ekt0810/buom-c3-eco/outputs/buom_c3_eco/THIRD_PARTY.md

# Nguồn và giấy phép

- Firmware ECO, mô hình MATLAB, tài liệu, schematic và bố trí carrier trong gói được soạn mới cho prototype này.
- Dự án cơ khí tham khảo: Max Imagination / ESP-FLUTTER, https://github.com/maximagination1/ESP-FLUTTER . Firmware gốc mang PolyForm Noncommercial; không sao chép vào mã ECO. Gói không phân phối STL có phí, blueprint hoặc firmware gốc. Mua/tải chúng từ tác giả theo điều khoản riêng.
- Footprint chuẩn và footprint XIAO biên 14 pad sửa từ KiCad Libraries: https://www.kicad.org/libraries/license/ . Thư viện KiCad dùng CC-BY-SA 4.0 kèm ngoại lệ cho thiết kế mạch; giữ thông báo này khi phân phối thư viện chỉnh sửa. Các footprint chuẩn được nhúng trong board KiCad.
- Three.js v0.180.0, MIT: https://github.com/mrdoob/three.js . Các tệp vendor được lưu cục bộ; giấy phép trong viewer/vendor/LICENSE.txt.
- Ảnh concept được tạo bằng imagegen, rồi chỉnh thành bản tiết kiệm. Nó không mô tả một sản phẩm đã chế tạo hoặc kiểm định.
- Các nhãn hiệu/mã linh kiện thuộc chủ sở hữu tương ứng; không thể suy ra chính hãng hoặc tồn kho của người bán từ tài liệu này.
