ekt0810/buom-c3-eco/outputs/buom_c3_eco/hardware/schematic.pdf

1 | 2 | 3 | 4 | 5 | 6 | 7 | 8 | 9 | 10 | 11
1 | 2 | 3 | 4 | 5 | 6 | 7 | 8 | 9 | 10 | 11

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
FGH Date: 2026-11-12

Size: A2 | Rev: A - prototype
KiCad E.D.A. 10.0.8 | Id: 1/1

## Title: Buom C3 carrier

File: buom_c3.kicad_sch

Sheet: /

1

1 | 2

2 R4

10k 1

1 | 2

2 R1

100k 1%

1

1 | 2

2 C1

100n 16V

1

1 | 2

2 R2

33k 1%

K

1 | A

2 D1

SS14

1

1 | 2
2 | 3

3 4

4 J3

IMU 4438

1

1 | 2
2 | 3

3 J5

LEFT SERVO

1

1 | 2

2 C3

100n 16V

1OE 1 | 1A 2 | 2Y 3 | GND 4 | 2A | 5 1Y | 6 2OE | 7 VCC | 8 U2

74AHCT2G125DP

1

1 | 2
2 | 3
3 J4 RP1 TX OUT D0/G2_NC 1 | D1/G3 2 | D2/G4_ADC 3 | D3/G5 4 | D4/G6_SDA 5 | D5/G7_SCL 6 | D6/G21 7 | D7/G20_RX | 8 D8/G8_NC | 9 D9/G9_NC | 10 D10/G10 | 11 3V3_OUT | 12 GND | 13 5V_IN | 14 U1

XIAO ESP32-C3

1

1 | 2
2 | 3

3 J6 RIGHT SERVO

1

1 | 2

2 C2

10u 16V | G
1 | S
2 | D

3 Q2

2N7002

1

1 | 2

2 C5

220u 16V low ESR

1

1 | 2

2 R3

100k 1

1 | 2

2 C4

10u 16V

1

1 | 2

2 R7

100R

1

1 | 2

2 R8

100k

S

1 | S
2 | S
3 | G
4 | D

5 D

6 D

7 D

8 Q1

AO4407A

1

1 | 2

2 J7

LED WING BUS

1

1 | 2

2 R12

100k pwr 1 PWR_FLAG

1

1 | 2

2 J1

2S BAT 6.6-8.4V

G

1 | S
2 | D

3 Q3

AO3400A

1

1 | 2

2 R5

100R

1

1 | 2
2 | 3

# 3 J2 BUCK external 1

1 | 2

2 R6

100k pwr 1 PWR_FLAG pwr 1 PWR_FLAG | pwr 1 PWR_FLAG

1

1 | 2

2 R9

220R

1

1 | 2

2 R10

220R

1

1 | 2

2 R11

100k PGATE +5V

VSERVO

VBAT

VSERVO

VBAT

XIAO_5V | GND +5V
PWM_L_5V | GND
GND | VSERVO +3V3 | GND
SDA | PWM_R_5V SCL VBAT_ADC | GND

GND

GND

XIAO_5V +5V | +5V CRSF_RX | GND
GND | PWM_R_3V3 PWM_L_3V3 | PWM_L_BUF

VBAT_ADC

VSERVO | GND

SERVO_EN

VBAT VBAT | VSERVO

VSERVO

VSERVO

VBAT | PGATE

PWM_R_BUF +3V3

LED_EN | LED_GATE

+5V GND

# VBAT PGATE

GND

GND

VBAT GND

+5V | LED_RETURN

XIAO_5V

XIAO_5V

VBAT_ADC

LED_RETURN

GND

PWM_R_3V3

SDA

EN_GATE

VBAT_ADC

SCL

EN_GATE | GND

LED_EN

GND | +5V

NGATE_D

VBAT

CRSF_RX

GND

GND

LED_GATE SERVO_EN | +5V | GND
LED_GATE | GND | PWM_L_BUF | PWM_L_5V

EN_GATE

PWM_R_BUF | PWM_R_5V

PWM_L_3V3

PWM_L_3V3 | GND | NGATE_D
PWM_R_3V3 | GND Q1 source pins 1/2/3 -> VBAT; drains 5/6/7/8 -> VSERVO. Gate pulled to source by R3: servo power OFF at reset. PWM is forced LOW before switching servo rail OFF. Use keyed battery cable; no reverse-polarity protection.

## BUOM C3 / REV A / 2S HV SERVO CARRIER

Do not fit a 1S-only servo or SG90/MG90S. Bench checks: polarity, 5V regulation, 3V3, ADC scale, servo pulse range, idle-off rail, current peaks, RF failsafe. U1 BAT pads NC. NEVER connect 2S to XIAO BAT or 5V. J2: external regulated 5V >= 1A; common GND. D1 prevents USB feeding the external 5V bus. J4: receiver TX -> MCU RX. Receiver RX unconnected.

Prototype: electrical CAD verified; flight and thermal performance unmeasured.

J7: 40 parallel LED branches, EACH with its own 2k2 resistor. White LED: +5V -> 2k2 -> anode; cathode -> LED_RETURN.

IMU at CG: X forward, Y left, Z up; leads <= 50mm. Digital signal levels are 3.3V except buffered servo PWM.
