ekt0810/buom-c3-eco/outputs/buom_c3_eco/images/pcb_top.png

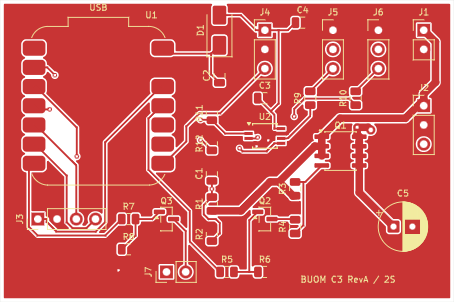
outputs/buom_c3_eco/images/pcb_top.png
