ekt0810/buom-c3-eco/outputs/buom_c3_eco/images/viewer_preview.png

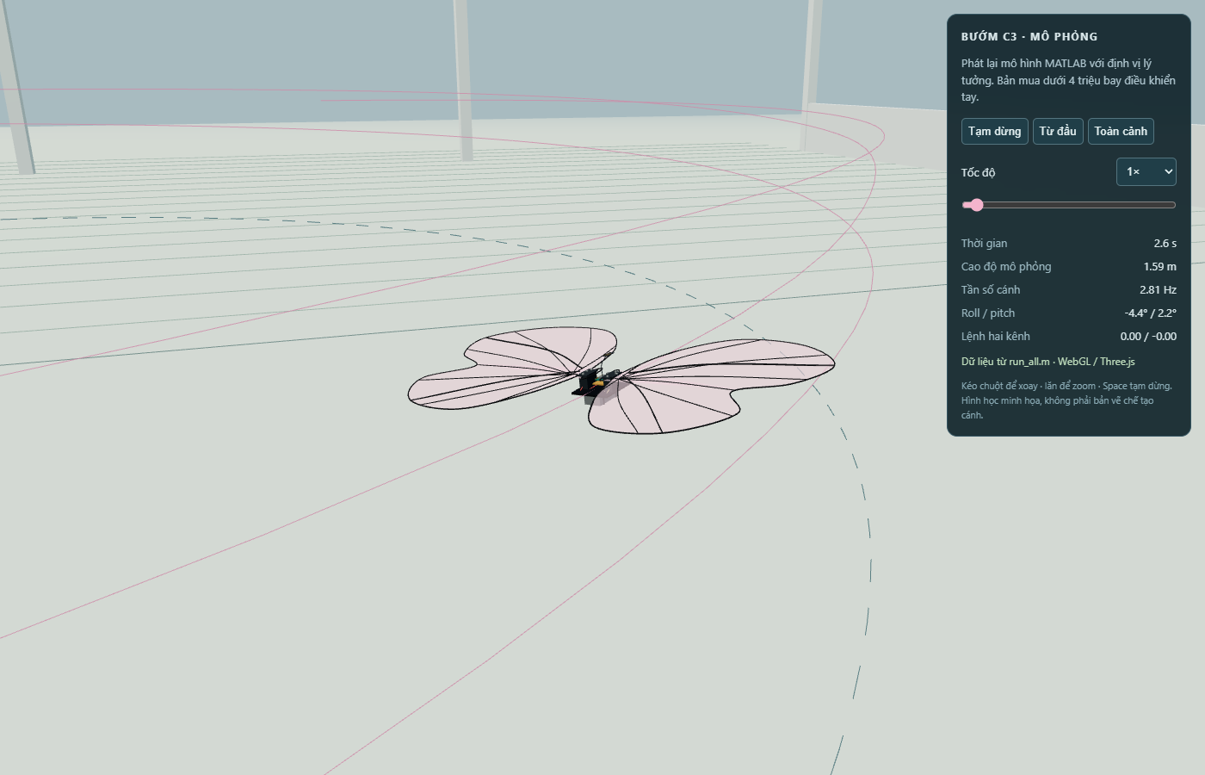
outputs/buom_c3_eco/images/viewer_preview.png
