ekt0810/buom-c3-eco/outputs/buom_c3_eco/BOM_Buom_C3.xlsx

Sheet: Mua linh kien
C3 ECO | BẢN TIẾT KIỆM / ESP-NOW
 | Điều khiển tay • không LED/IMU/ELRS |  |  |  |  |  |  | Giá dự toán, cần kiểm tra khi đặt hàng | Đã gồm 400k vận chuyển/dự phòng; chưa gồm dụng cụ đo/hàn.
 | Dự toán 12/11/2026; chưa có báo giá chốt |  | Trần ngân sách | 4000000 |  |  |  | Cột G: khối lượng vật tư mua | Khối lượng cất cánh tính riêng ở tab Khối lượng.
 |  |  | Tổng dự toán | 3865000
 |  |  | Dư địa còn lại | 135000
ID | Linh kiện / mã cụ thể | SL mua | Đơn giá VND | Thành tiền VND | g/đv tham khảo | Khối lượng mua | Nhóm | Nguồn / link hãng | Ghi chú đặt hàng
A01 | XIAO ESP32-C3 + anten đi kèm | 1 | 170000 | 170000 | 3.50 | 3.50 | Bướm | https://hshop.vn/mach-seeed-studio-xiao-esp32c3-risc-v-with-wi-fi-bluetooth5-0-battery-charge-supported | Giá tham khảo; các giá còn lại là dự toán cần hỏi người bán.
A02 | SDS1601 HV 180° / 2S, kèm horn | 2 | 650000 | 1300000 | 16.00 | 32.00 | Bướm | https://www.elektormagazine.com/labs/make-an-esp32-rc-bionic-butterfly-that-flies-esp-flutter | Mục trần: <=650k/con. Phải đúng bản HV chịu pin đầy 8.4V và >=750°/s không tải. Đặt theo link parts của tác giả, không thay SG90.
A03 | LiPo 2S 220mAh >=45C | 1 | 220000 | 220000 | 13.00 | 13.00 | Bướm | https://www.elektormagazine.com/labs/make-an-esp32-rc-bionic-butterfly-that-flies-esp-flutter | Chỉ mua 1 pin đợt đầu. Xác nhận dòng tải, kích thước, cân nặng và giắc.
A04 | Mini-360 MP2307 buck chỉnh 5.0V | 1 | 30000 | 30000 | 2.00 | 2.00 | Bướm | https://www.monolithicpower.com/en/mp2307.html | Dự toán module; đo 5.0V trước cắm XIAO. Thử 0.5A liên tục; không lấy 5V cấp servo HV.
A05 | Bộ mạch nguồn/PWM + bảng lỗ nhỏ | 1 | 90000 | 90000 | 2.00 | 2.00 | Bướm | Schematic và tab PCB trong gói | Gồm AHCT2G125 + adapter TSSOP, SS14, AO4407A, 2N7002, R/C, dây. Nếu khó hàn: dùng PCB carrier tùy chọn trong khoản dự phòng.
M01 | Carbon 1mm (1m/cây) | 4 | 45000 | 180000 | 10.00 | 40.00 | Cơ khí | https://www.elektormagazine.com/labs/make-an-esp32-rc-bionic-butterfly-that-flies-esp-flutter | Cắt theo bản cánh gốc; khối lượng đây là vật tư mua, không phải khối lượng lắp.
M02 | Carbon 1.5mm (1m) | 1 | 60000 | 60000 | 3.00 | 3.00 | Cơ khí | Nguồn cơ khí của ESP-FLUTTER | Không phóng tỷ lệ cánh tùy ý.
M03 | Màng PE 10-20um khoảng 0.5m² | 1 | 50000 | 50000 | 10.00 | 10.00 | Cơ khí | Quy cách tìm mua; chưa xác nhận nhà bán | Cân tổng hai bên cánh + gân + keo <=16g làm mục tiêu ban đầu.
M04 | Khung đúng servo: file gốc + in nhẹ | 1 | 250000 | 250000 | 5.00 | 5.00 | Cơ khí | https://cults3d.com/en/3d-model/game/esp-flutter-an-esp32-bionic-rc-butterfly-that-flies-3d-design-files-max_imagination | Dự toán tổng. File gốc có phí, không kèm trong gói. Giữ hình học cơ sở đã bay; không dùng hình AI làm bản cắt.
M05 | Vít, keo, horn, dây, XT30, băng dính | 1 | 100000 | 100000 | 4.00 | 4.00 | Bướm | Quy cách lắp trong hướng dẫn | Dây pin và servo 24AWG ngắn; tín hiệu 30AWG. Horn lấy theo servo.
T01 | ESP32 DevKit V1 / ESP32-WROOM-32 | 1 | 120000 | 120000 | 0.00 | 0.00 | Tay phát | https://docs.espressif.com/projects/arduino-esp32/en/latest/ | Board mặt đất; không dùng ESP32-C3 thay chân mà không sửa firmware.
T02 | Joystick XY 10k + biến trở ga 10k | 1 | 35000 | 35000 | 0.00 | 0.00 | Tay phát | ADC1 GPIO32/33/34, dùng nguồn 3.3V | Joystick điều khiển roll/pitch; núm ga không tự hồi. Hiệu chuẩn ADC trước arm.
T03 | Công tắc ARM, piezo, LED, hộp, dây | 1 | 50000 | 50000 | 0.00 | 0.00 | Tay phát | Sơ đồ tay phát trong hướng dẫn | Piezo thụ động qua 1k; LED qua 1k. ARM nối GPIO25 xuống GND.
T04 | Nguồn USB 5V/power bank nhỏ cho tay phát | 1 | 150000 | 150000 | 0.00 | 0.00 | Tay phát | Có thể dùng power bank sẵn có để tiết kiệm | Tránh power bank tự tắt ở tải thấp; thử 15 phút.
G01 | Sạc cân bằng 2S, chỉnh được dòng 0.2A | 1 | 450000 | 450000 | 0.00 | 0.00 | Mặt đất | Yêu cầu mua: 2S LiPo balance, dòng 0.2A | Không mua sạc 1S TP4056. Sạc theo thông số pin; 1C của 220mAh là 0.22A.
G02 | Túi sạc và dây cân bằng phù hợp pin | 1 | 60000 | 60000 | 0.00 | 0.00 | Mặt đất | Quy cách theo giắc pin | Dự toán. Không dùng cổng BAT của XIAO để sạc 2S.
G03 | Nguồn DC cho sạc, dự toán 12V 3A | 1 | 150000 | 150000 | 0.00 | 0.00 | Mặt đất | Theo điện áp/giắc IN của bộ sạc thực mua | Bổ sung để không thiếu nguồn sạc. Chỉ chọn 12V khi bộ sạc hỗ trợ; nguồn SELV có vỏ, không nguồn hở. Nếu sạc đã tích hợp AC thì bỏ mục này.
D01 | Dự phòng vận chuyển / linh kiện lỗi | 1 | 400000 | 400000 | 0.00 | 0.00 | Dự phòng | Ngân sách dự phòng, không phải báo giá | Có thể dùng một phần để làm carrier PCB hoặc thuê hàn.

Sheet: PCB
PCB | PCB TÙY CHỌN / KHÔNG BẮT BUỘC
 | Bản tiết kiệm dùng bảng lỗ theo cùng netlist |  | DNP: J3, J4, J7, Q3, R7, R8 | Không mua IMU, ELRS, LED. U1 đã nằm ở A01; vật tư mạch nằm ở A05.
Refdes | Giá trị / MPN | SL | Footprint | Net từng pad
U1 | XIAO ESP32-C3 | 1 | Buom:MCU_Seeed_C3_top14 | 1:NC; 2:PWM_L_3V3; 3:VBAT_ADC; 4:PWM_R_3V3; 5:SDA; 6:SCL; 7:LED_EN; 8:CRSF_RX; 9:NC; 10:NC; 11:SERVO_EN; 12:+3V3; 13:GND; 14:XIAO_5V
J1 | 2S BAT 6.6-8.4V | 1 | Connector_PinHeader_2.54mm:PinHeader_1x02_P2.54mm_Vertical | 1:VBAT; 2:GND
J2 | BUCK external | 1 | Connector_PinHeader_2.54mm:PinHeader_1x03_P2.54mm_Vertical | 1:VBAT; 2:GND; 3:+5V
J3 | IMU 4438 | 0 | Connector_PinHeader_2.54mm:PinHeader_1x04_P2.54mm_Vertical | 1:+3V3; 2:GND; 3:SDA; 4:SCL
J4 | RP1 TX OUT | 0 | Connector_PinHeader_2.54mm:PinHeader_1x03_P2.54mm_Vertical | 1:+5V; 2:GND; 3:CRSF_RX
J5 | LEFT SERVO | 1 | Connector_PinHeader_2.54mm:PinHeader_1x03_P2.54mm_Vertical | 1:GND; 2:VSERVO; 3:PWM_L_5V
J6 | RIGHT SERVO | 1 | Connector_PinHeader_2.54mm:PinHeader_1x03_P2.54mm_Vertical | 1:GND; 2:VSERVO; 3:PWM_R_5V
J7 | LED WING BUS | 0 | Connector_PinHeader_2.54mm:PinHeader_1x02_P2.54mm_Vertical | 1:+5V; 2:LED_RETURN
U2 | 74AHCT2G125DP | 1 | Package_SO:TSSOP-8_3x3mm_P0.65mm | 1:GND; 2:PWM_L_3V3; 3:PWM_R_BUF; 4:GND; 5:PWM_R_3V3; 6:PWM_L_BUF; 7:GND; 8:+5V
R1 | 100k 1% | 1 | Resistor_SMD:R_0805_2012Metric | 1:VBAT; 2:VBAT_ADC
R2 | 33k 1% | 1 | Resistor_SMD:R_0805_2012Metric | 1:VBAT_ADC; 2:GND
C1 | 100n 16V | 1 | Capacitor_SMD:C_0805_2012Metric | 1:VBAT_ADC; 2:GND
D1 | SS14 | 1 | Diode_SMD:D_SMA | 1:XIAO_5V; 2:+5V
C2 | 10u 16V | 1 | Capacitor_SMD:C_0805_2012Metric | 1:XIAO_5V; 2:GND
C3 | 100n 16V | 1 | Capacitor_SMD:C_0805_2012Metric | 1:+5V; 2:GND
C4 | 10u 16V | 1 | Capacitor_SMD:C_0805_2012Metric | 1:+5V; 2:GND
Q1 | AO4407A | 1 | Package_SO:SOIC-8_3.9x4.9mm_P1.27mm | 1:VBAT; 2:VBAT; 3:VBAT; 4:PGATE; 5:VSERVO; 6:VSERVO; 7:VSERVO; 8:VSERVO
R3 | 100k | 1 | Resistor_SMD:R_0805_2012Metric | 1:VBAT; 2:PGATE
R4 | 10k | 1 | Resistor_SMD:R_0805_2012Metric | 1:PGATE; 2:NGATE_D
Q2 | 2N7002 | 1 | Package_TO_SOT_SMD:SOT-23 | 1:EN_GATE; 2:GND; 3:NGATE_D
R5 | 100R | 1 | Resistor_SMD:R_0805_2012Metric | 1:SERVO_EN; 2:EN_GATE
R6 | 100k | 1 | Resistor_SMD:R_0805_2012Metric | 1:EN_GATE; 2:GND
Q3 | AO3400A | 0 | Package_TO_SOT_SMD:SOT-23 | 1:LED_GATE; 2:GND; 3:LED_RETURN
R7 | 100R | 0 | Resistor_SMD:R_0805_2012Metric | 1:LED_EN; 2:LED_GATE
R8 | 100k | 0 | Resistor_SMD:R_0805_2012Metric | 1:LED_GATE; 2:GND
R9 | 220R | 1 | Resistor_SMD:R_0805_2012Metric | 1:PWM_L_BUF; 2:PWM_L_5V
R10 | 220R | 1 | Resistor_SMD:R_0805_2012Metric | 1:PWM_R_BUF; 2:PWM_R_5V
R11 | 100k | 1 | Resistor_SMD:R_0805_2012Metric | 1:PWM_L_3V3; 2:GND
R12 | 100k | 1 | Resistor_SMD:R_0805_2012Metric | 1:PWM_R_3V3; 2:GND
C5 | 220u 16V low ESR | 1 | Capacitor_THT:CP_Radial_D6.3mm_P2.50mm | 1:VSERVO; 2:GND

Sheet: Khoi luong
KHỐI LƯỢNG | BẢN TIẾT KIỆM
Ước tính, chưa cân mẫu thật |  |  | Cân từng cụm; không bay nếu lực nâng thử không đủ.
Cụm lắp trên bướm | Ước tính g | Đo thực g | Ghi chú
2 servo HV | 32.00 |  | Chưa cân
Cánh + carbon | 16.00 |  | Chưa cân
Khung, horn, vít | 5.00 |  | Chưa cân
Pin 2S 220mAh | 13.00 |  | Chưa cân
XIAO + anten | 3.50 |  | Chưa cân
Mini360 buck | 2.00 |  | Chưa cân
Mạch bảng lỗ + linh kiện | 2.00 |  | Chưa cân
Dây, giắc, keo | 4.00 |  | Chưa cân
LED (không lắp) | 0.00 |  | Chưa cân
IMU (không lắp) | 0.00 |  | Chưa cân
ELRS (không lắp) | 0.00 |  | Chưa cân
Tải mang (không lắp) | 0.00 |  | Chưa cân
Tổng dự kiến (không LED / tải) | 77.50
Khối lượng dùng cho mô phỏng | 77.50
Lực nâng mục tiêu 1.3 x trọng lượng (N) | 0.99
