ekt0810/buom-c3-eco/outputs/buom_c3_eco/matlab/results/trajectory.csv

t | x | y | z | V | psi | phi | theta | wingL_deg | wingR_deg | uRoll | uPitch | f_Hz
0 | 8 | 0 | 1.5 | 2 | 1.5707963 | -0.050924333 | 0 | 0.45075037 | 0.45075037 | -0.072873649 | 0.031552526 | 2.861547
0.02 | 8.0039 | 0.037999835 | 1.5001987 | 2.0000004 | 1.5757975 | -0.050970053 | 1.3860812e-05 | 8.8602119 | 9.672899 | -0.06741536 | 0.033355489 | 2.8567105
0.04 | 8.0075997 | 0.075998706 | 1.5007549 | 2.000005 | 1.580813 | -0.051247258 | 9.4809378e-05 | 16.068524 | 17.185542 | -0.04952239 | 0.012605253 | 2.8525396
0.06 | 8.0110981 | 0.11399576 | 1.5016135 | 2.0000223 | 1.5858731 | -0.051891228 | 0.00027744636 | 21.595443 | 22.837907 | -0.041172022 | 0.014862305 | 2.8489782
0.08 | 8.0143925 | 0.1519903 | 1.5027251 | 2.0000633 | 1.5910164 | -0.05293968 | 0.00058361919 | 24.35475 | 25.851507 | -0.044066806 | 0.023556117 | 2.8459683
0.1 | 8.0174789 | 0.18998178 | 1.504046 | 2.00014 | 1.5962821 | -0.054376881 | 0.0010215176 | 24.252685 | 25.125825 | -0.02609978 | 0.020704188 | 2.8434525
0.12 | 8.0203516 | 0.2279698 | 1.5055371 | 2.0002644 | 1.601706 | -0.056150772 | 0.0015851801 | 20.800537 | 21.439509 | -0.022249909 | 0.012588803 | 2.8413756
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
