ekt0810/buom-c3-eco/outputs/buom_c3_eco/matlab/results/gust_comparison.png

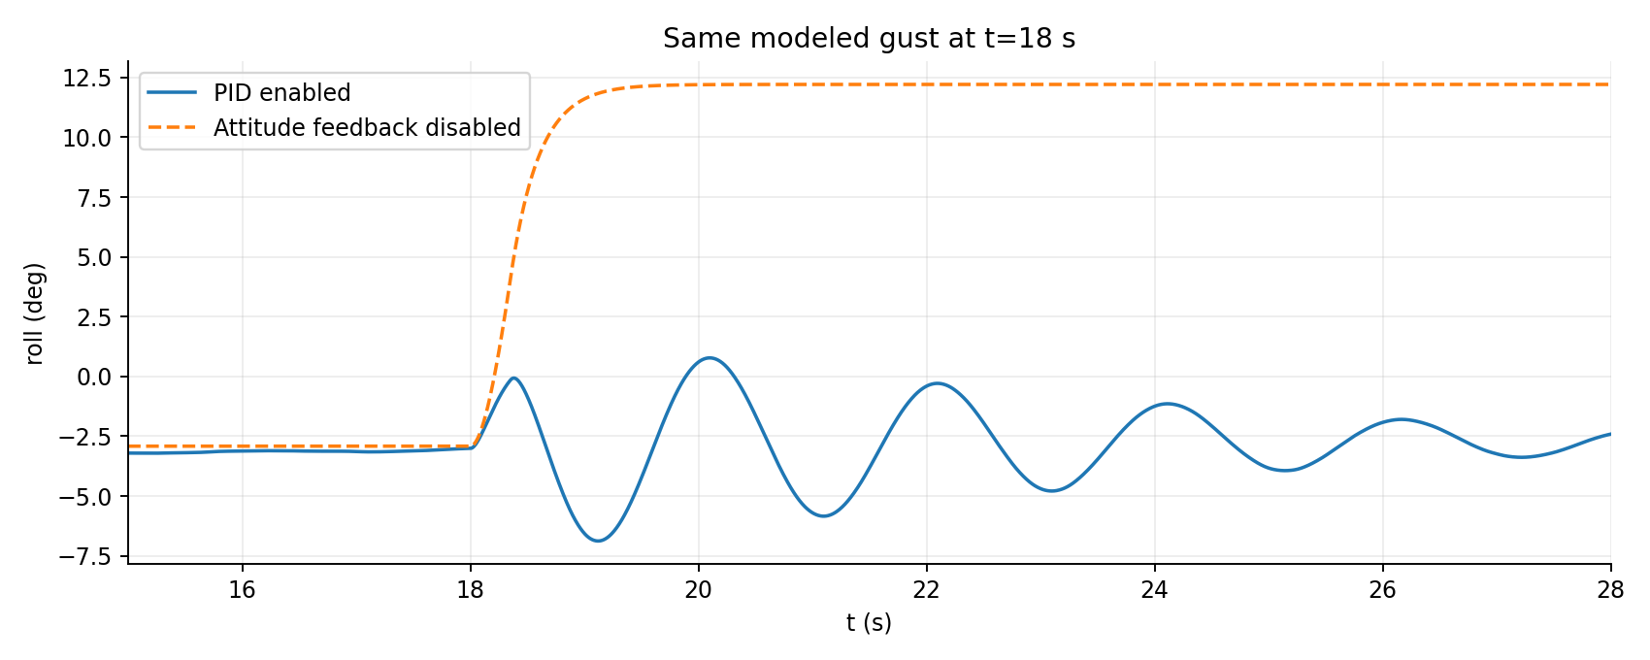
outputs/buom_c3_eco/matlab/results/gust_comparison.png
