ekt0810/buom-c3-eco/outputs/buom_c3_eco/hardware/buom_c3.kicad_pcb

## KiCad design outputs/buom_c3_eco/hardware/buom_c3.kicad_pcb (2026-11-12)

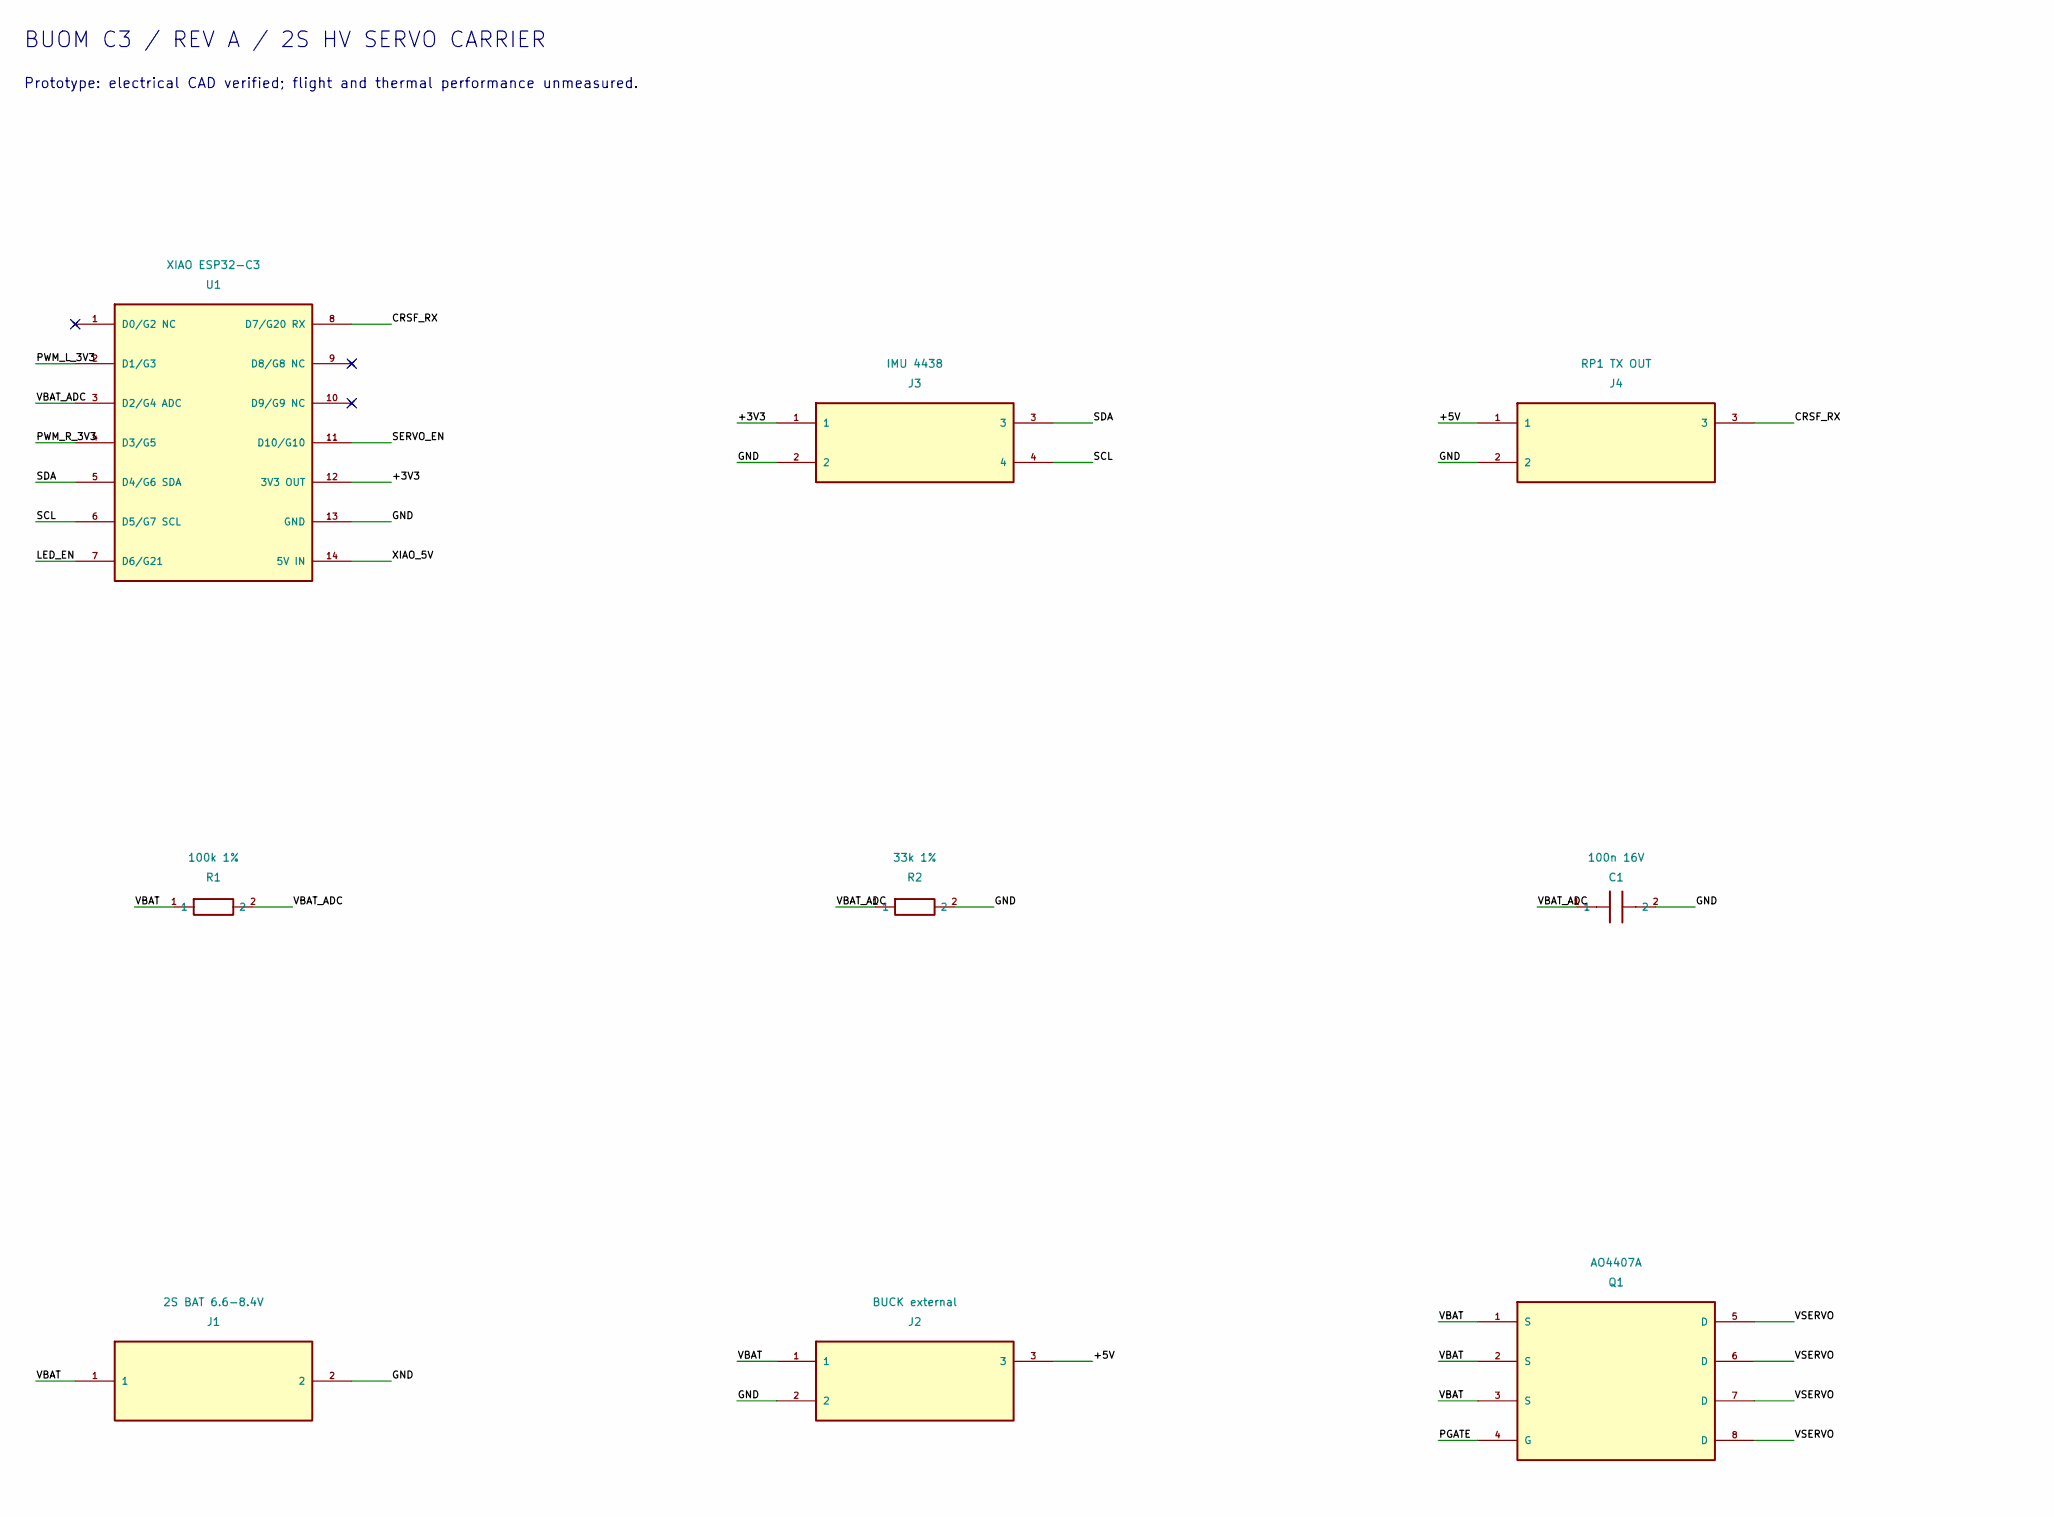
[picture p8: schematic buom_c3.kicad_sch, Buom C3 carrier, part in row 1, column 1]

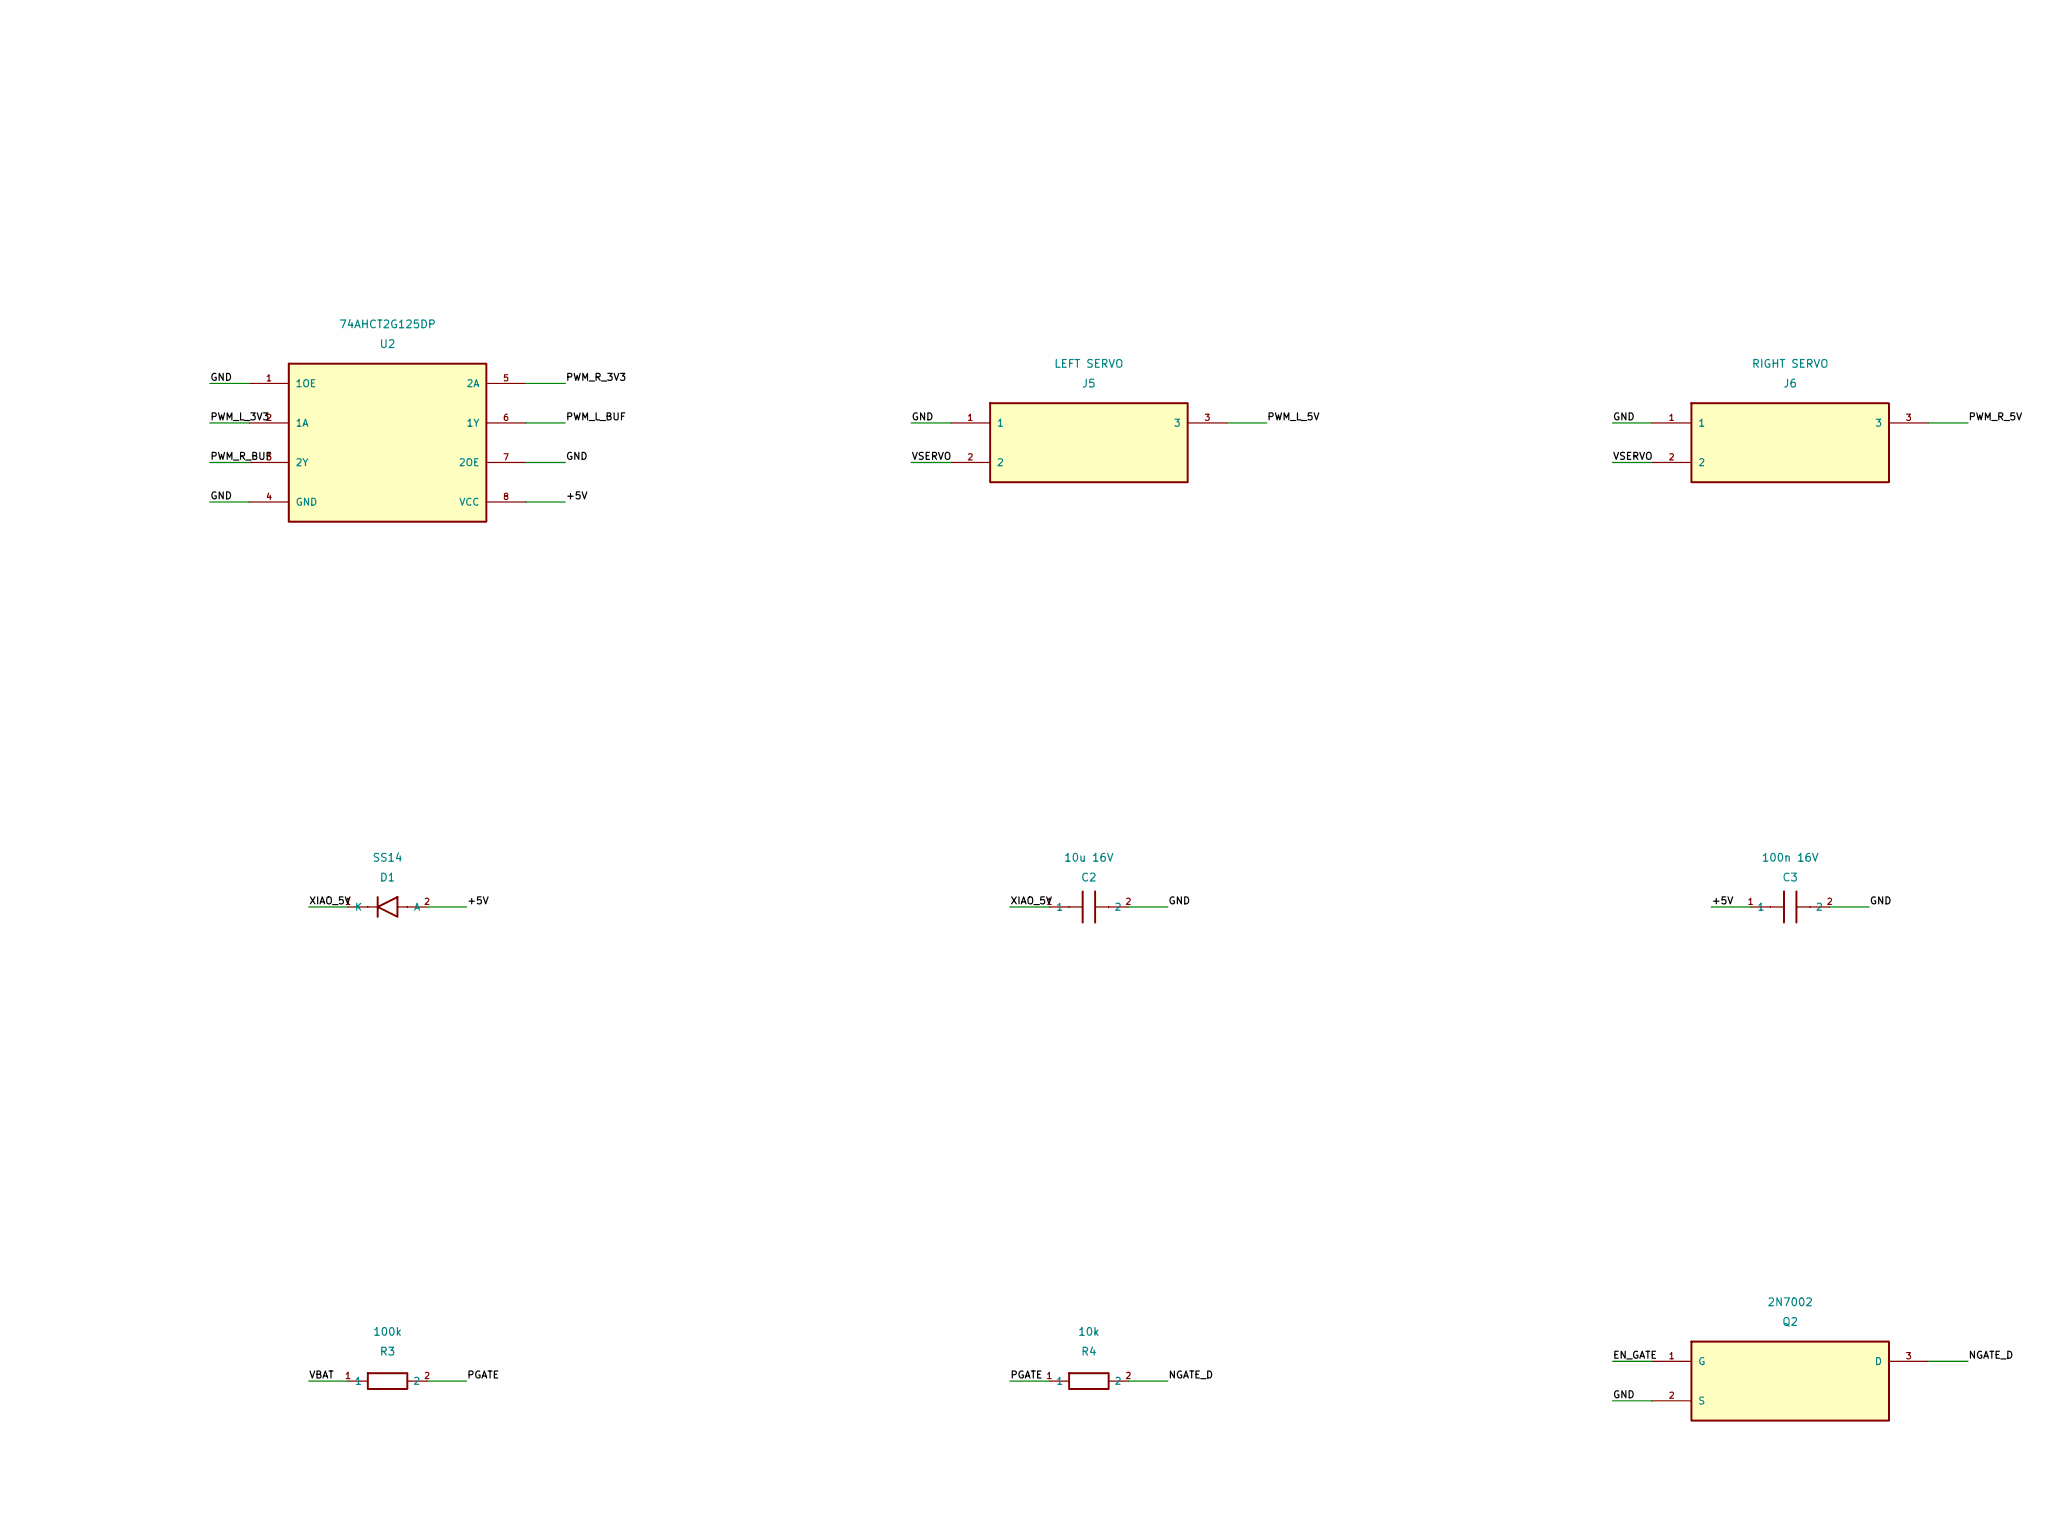
[picture p9: schematic buom_c3.kicad_sch, Buom C3 carrier, part in row 1, column 2]

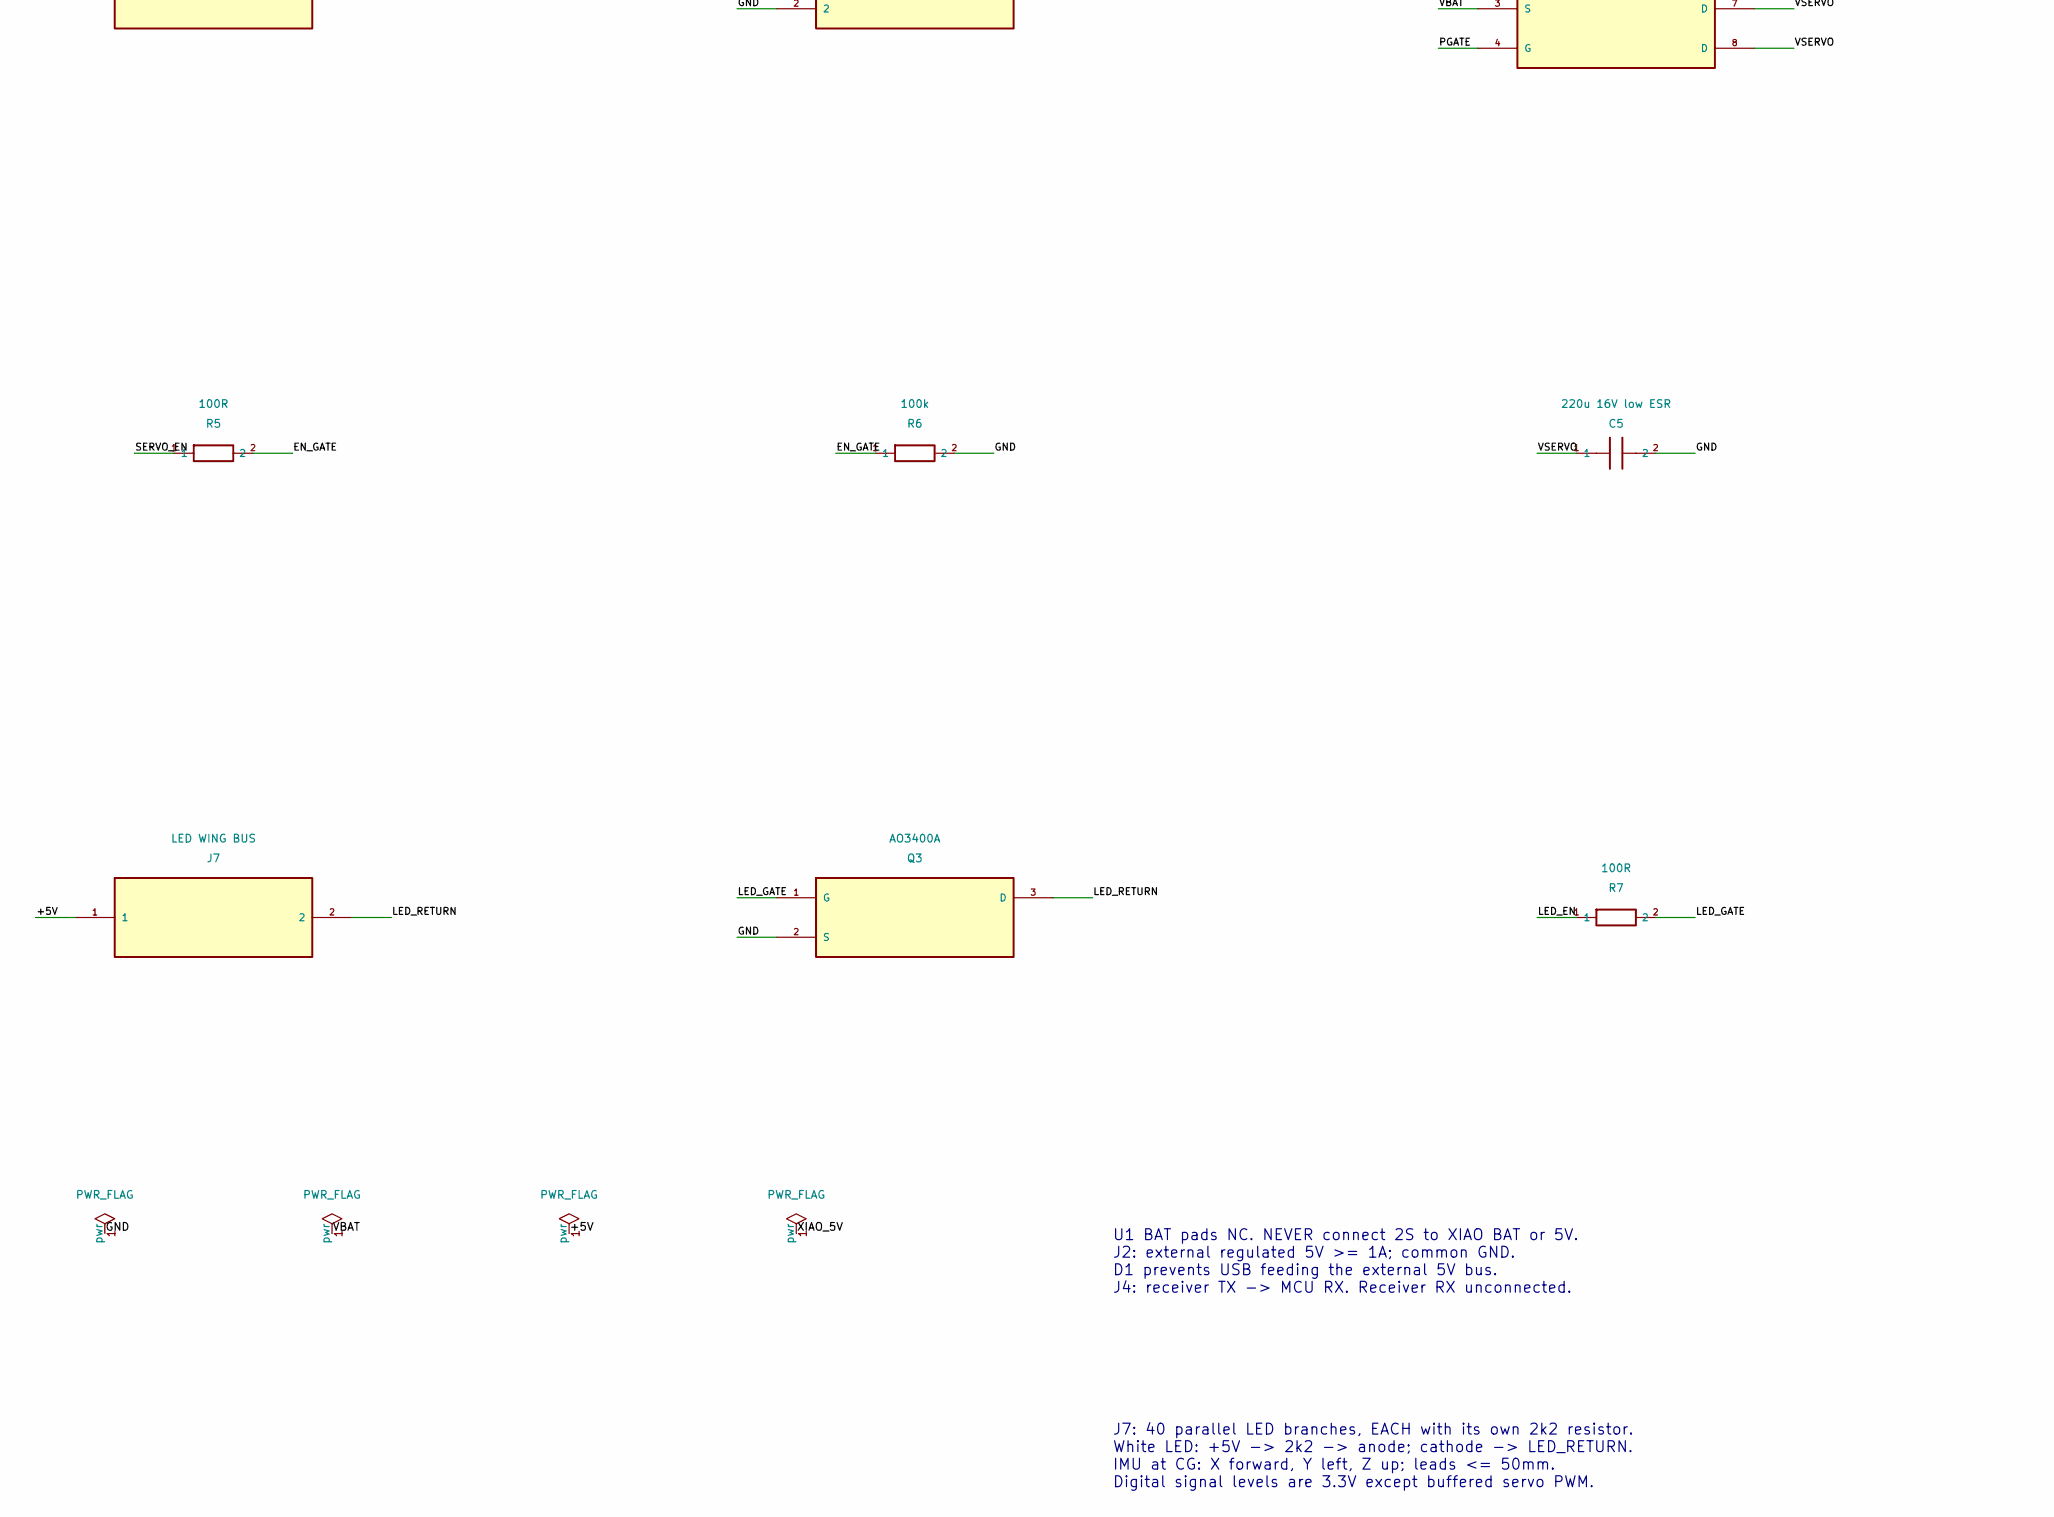
[picture p10: schematic buom_c3.kicad_sch, Buom C3 carrier, part in row 2, column 1]

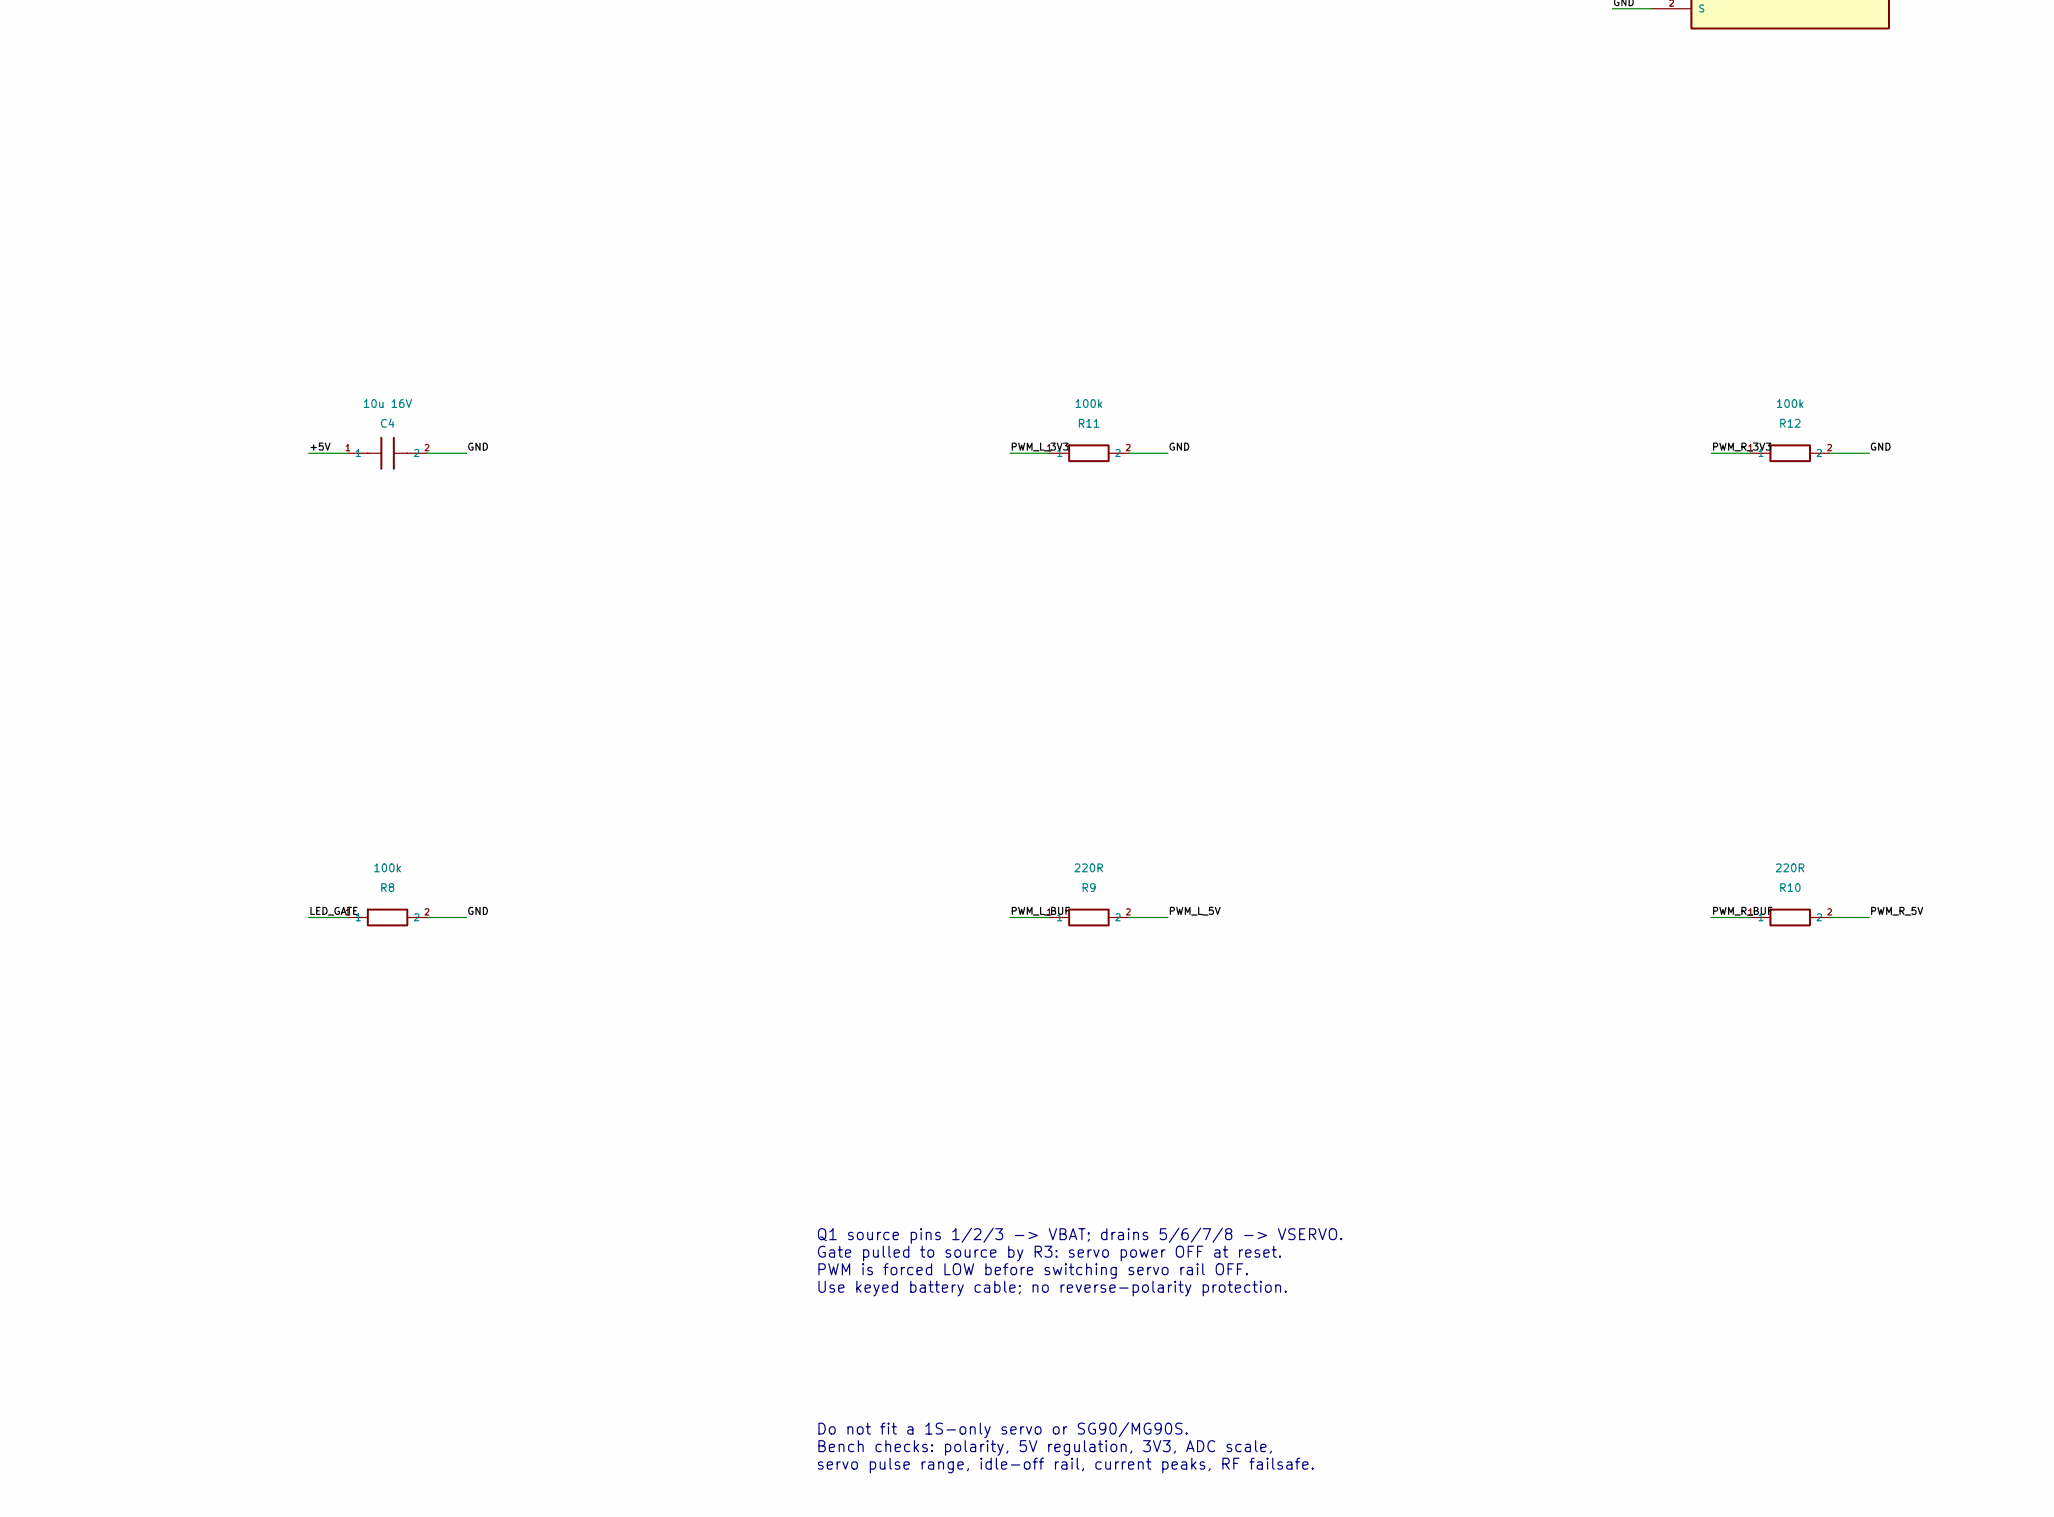
[picture p11: schematic buom_c3.kicad_sch, Buom C3 carrier, part in row 2, column 2]

Parts:
C1, C3: 100n 16V; C_0805_2012Metric
C2, C4: 10u 16V; C_0805_2012Metric
C5: 220u 16V low ESR; CP_Radial_D6.3mm_P2.50mm
D1: SS14; D_SMA
J1: 2S BAT 6.6-8.4V; PinHeader_1x02_P2.54mm_Vertical
J2: BUCK external; PinHeader_1x03_P2.54mm_Vertical
J3: IMU 4438; PinHeader_1x04_P2.54mm_Vertical
J4: RP1 TX OUT; PinHeader_1x03_P2.54mm_Vertical
J5: LEFT SERVO; PinHeader_1x03_P2.54mm_Vertical
J6: RIGHT SERVO; PinHeader_1x03_P2.54mm_Vertical
J7: LED WING BUS; PinHeader_1x02_P2.54mm_Vertical
Q1: AO4407A; SOIC-8_3.9x4.9mm_P1.27mm
Q2: 2N7002; SOT-23
Q3: AO3400A; SOT-23
R1: 100k 1%; R_0805_2012Metric
R2: 33k 1%; R_0805_2012Metric
R3, R6, R8, R11, R12: 100k; R_0805_2012Metric
R4: 10k; R_0805_2012Metric
R5, R7: 100R; R_0805_2012Metric
R9, R10: 220R; R_0805_2012Metric
U1: XIAO ESP32-C3; MCU_Seeed_C3_top14
U2: 74AHCT2G125DP; TSSOP-8_3x3mm_P0.65mm

Connections:
/+3V3: J3.1, U1.12 (3V3 OUT)
/+5V: C3.1, C4.1, D1.2 (A), J2.3, J4.1, J7.1, U2.8 (VCC)
/CRSF_RX: J4.3, U1.8 (D7/G20 RX)
/EN_GATE: Q2.1 (G), R5.2, R6.1
/GND: C1.2, C2.2, C3.2, C4.2, C5.2, J1.2, J2.2, J3.2, J4.2, J5.1, J6.1, Q2.2 (S), Q3.2 (S), R2.2, R6.2, R8.2, R11.2, R12.2, U1.13 (GND), U2.1 (1OE), U2.4 (GND), U2.7 (2OE)
/LED_EN: R7.1, U1.7 (D6/G21)
/LED_GATE: Q3.1 (G), R7.2, R8.1
/LED_RETURN: J7.2, Q3.3 (D)
/NGATE_D: Q2.3 (D), R4.2
/PGATE: Q1.4 (G), R3.2, R4.1
/PWM_L_3V3: R11.1, U1.2 (D1/G3), U2.2 (1A)
/PWM_L_5V: J5.3, R9.2
/PWM_L_BUF: R9.1, U2.6 (1Y)
/PWM_R_3V3: R12.1, U1.4 (D3/G5), U2.5 (2A)
/PWM_R_5V: J6.3, R10.2
/PWM_R_BUF: R10.1, U2.3 (2Y)
/SCL: J3.4, U1.6 (D5/G7 SCL)
/SDA: J3.3, U1.5 (D4/G6 SDA)
/SERVO_EN: R5.1, U1.11 (D10/G10)
/VBAT: J1.1, J2.1, Q1.1 (S), Q1.2 (S), Q1.3 (S), R1.1, R3.1
/VBAT_ADC: C1.1, R1.2, R2.1, U1.3 (D2/G4 ADC)
/VSERVO: C5.1, J5.2, J6.2, Q1.5 (D), Q1.6 (D), Q1.7 (D), Q1.8 (D)
/XIAO_5V: C2.1, D1.1 (K), U1.14 (5V IN)

Notes on the sheet:
BUOM C3 / REV A / 2S HV SERVO CARRIER
Prototype: electrical CAD verified; flight and thermal performance unmeasured.
U1 BAT pads NC. NEVER connect 2S to XIAO BAT or 5V. J2: external regulated 5V >= 1A; common GND. D1 prevents USB feeding the external 5V bus. J4: receiver TX -> MCU RX. Receiver RX unconnected.
Q1 source pins 1/2/3 -> VBAT; drains 5/6/7/8 -> VSERVO. Gate pulled to source by R3: servo power OFF at reset. PWM is forced LOW before switching servo rail OFF. Use keyed battery cable; no reverse-polarity protection.
J7: 40 parallel LED branches, EACH with its own 2k2 resistor. White LED: +5V -> 2k2 -> anode; cathode -> LED_RETURN. IMU at CG: X forward, Y left, Z up; leads <= 50mm. Digital signal levels are 3.3V except buffered servo PWM.
Do not fit a 1S-only servo or SG90/MG90S. Bench checks: polarity, 5V regulation, 3V3, ADC scale, servo pulse range, idle-off rail, current peaks, RF failsafe.

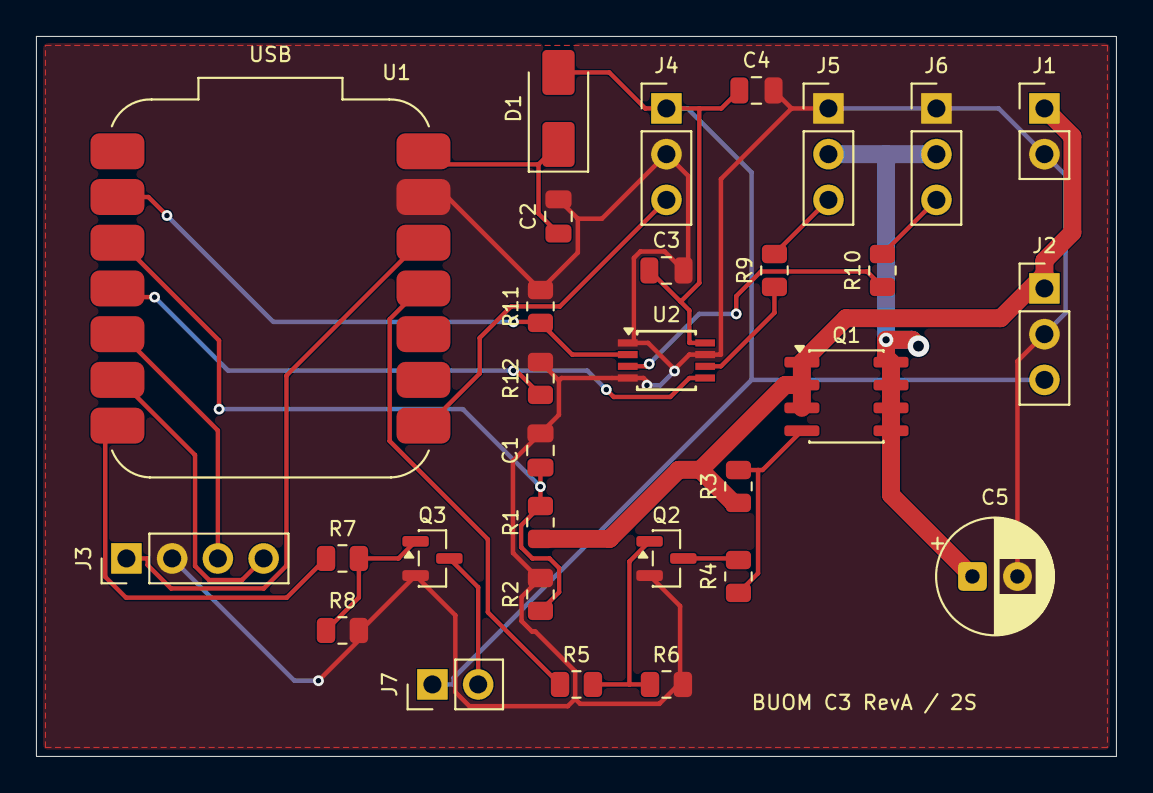
[picture p12: board buom_c3.kicad_pcb from above]

Board: 2 copper layers, 60.0 x 40.0 mm, 30 parts (0 on the bottom side), 23 nets.
